AxxAxx/AxxLoad/HARDWARE/eagle design files/AxxLOAD_V2/Assembly/PnP_electronicload_front.txt

LD1	-94.05	16.55	0.00		CHIP-LED0805
LD2	-94.05	26.95	0.00		CHIP-LED0805
LD3	-92.00	-30.00	180.00		CHIP-LED0805
LD4	-108.00	-30.00	180.00		CHIP-LED0805
LD5	-94.30	33.00	270.00	HSMF-A201-A00J1	AVAGO_PLCC4
R13	-89.50	34.00	180.00	330	R0805
R17	-89.50	32.00	180.00	330	R0805
R23	-94.05	12.55	270.00	15	R0805
R24	-94.05	22.95	270.00	15	R0805
R25	-108.00	-26.00	270.00	15	R0805
