AxxAxx/AxxLoad/HARDWARE/BOM.xlsx

https://www.elfa.se/en/surge-stopper-34v-sot-23-linear-technology-ltc4365cts8-trmpbf/p/30167472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
https://www.elfa.se/en/mosfet-dual-channel-40v-powerpak-so-8l-vishay-sqj208ep-t1-ge3/p/30156768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
https://www.elfa.se/en/ntc-thermistor-ntc-10kohm-3984k-41mm-vishay-ntcle305e4103sb/p/30153875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
https://www.elfa.se/en/clip-for-heat-sink-to-264-ohmite-cla-t264-21e/p/30118216?track=true&no-cache=true
