AxxAxx/AxxLoad/(threads)

Thread 2 (2020-11-17):

Add Overvoltage protection for 12V Input

AxxAxx, 2020-11-17:
Protect the AxxLOAD by protecting the input circuit.
Example: https://circuitdigest.com/electronic-circuits/overvoltage-protection-circuit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,burn%20and%20break%20the%20circuit.
