AxxAxx/AxxLoad/Schematic.pdf

MICROCONTROLLER BOARD | OP-AMP CIRCUIT
+5V | +12V

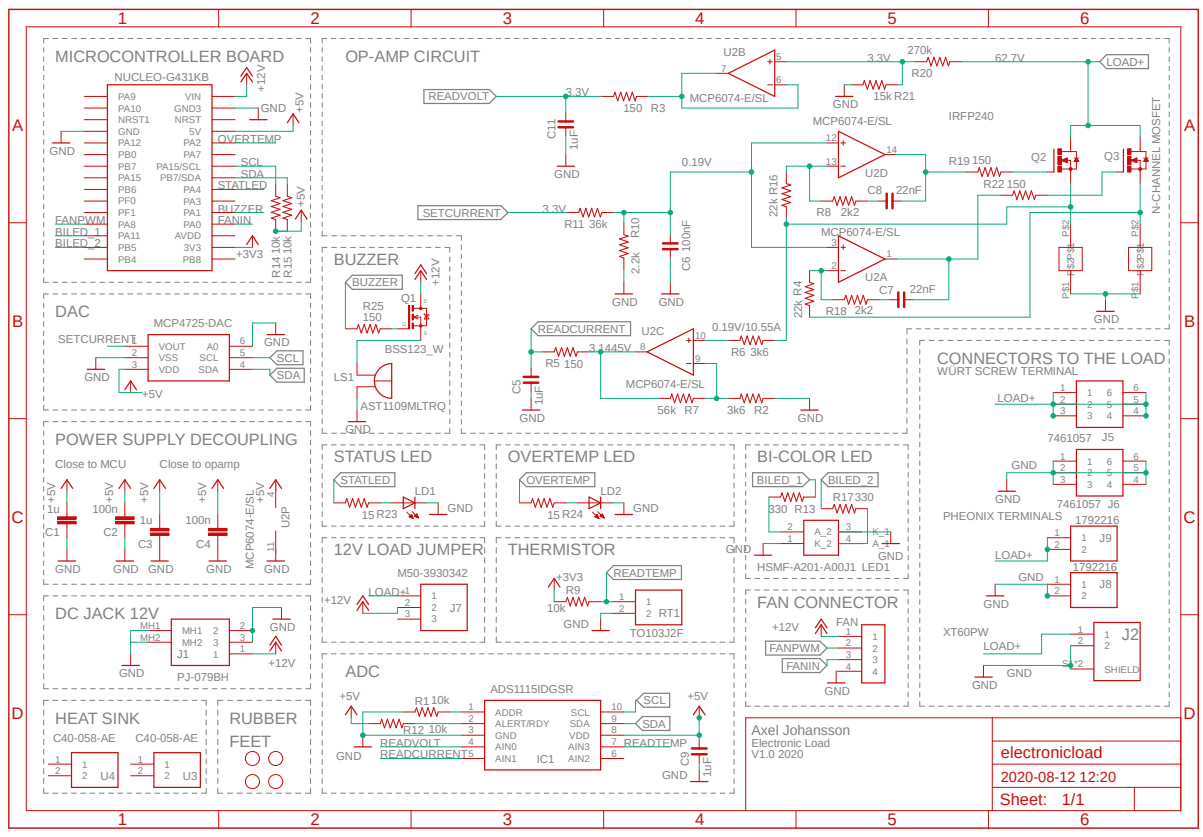
[picture p1: page 1]

CONNECTORS TO THE LOAD

3 | 3 4 | 4

C | GND 7461057 | C

Axel Johansson Electronic Load V1.0 2020

Sheet: 1/1
