AxxAxx/AxxLoad/HARDWARE/eagle design files/electronicload.brd

## EAGLE design HARDWARE/eagle design files/electronicload.brd (2020-11-15)

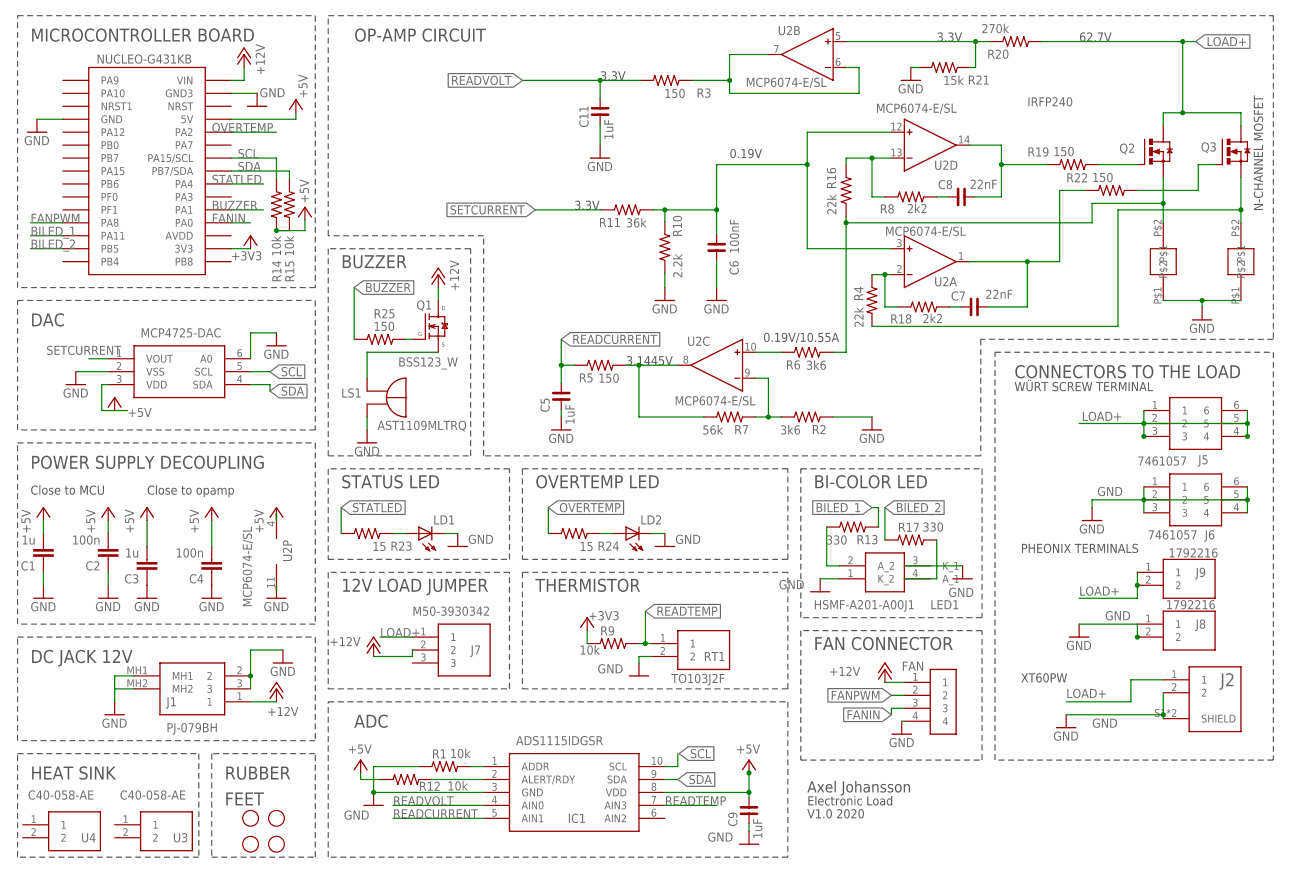
[picture p2: schematic electronicload.sch]

Parts:
C1, C3: 1u; C0603K; TOLERANCE 10%; VOLTAGE 16V; DIGIKEY 311-1444-1-ND
C2, C4: 100n; C0603K; TOLERANCE 10%; VOLTAGE 50V; DIGIKEY 445-7456-1-ND
C5, C9, C11: 1uF; C0805
C6: 100nF; C0805
C7, C8: 22nF; C0805
FAN: B4B-PH-K-S(LF)(SN); JST_B4B-PH-K-S(LF)(SN)
IC1: ADS1115IDGSR; SOP50P490X110-10N
J1: PJ-079BH; PJ079BH
J2: XT60PW-F; AMASS_XT60PW-F
J5, J6: 7461057
J7: M50-3930342; M503930342
J8, J9: 1792216
LD1, LD2: LEDCHIP-LED0805; CHIP-LED0805
LED1: HSMF-A201-A00J1; AVAGO_PLCC4
LS1: AST1109MLTRQ; XDCR_AST1109MLTRQ
MCP4725-DAC: MCP4725A0T-E_CH; SOT95P270X145-6N
Q1: BSS123_W; SOT23_GSD_W
Q2, Q3: IRFP240; TO247AC
R1, R9, R12, R14, R15: 10k; R0805
R2, R6: 3k6; R0805
R3, R5, R19, R22, R25: 150; R0805
R4, R16: 22k; R0805
R7: 56k; R0805
R8, R18: 2k2; R0805
R10: 2.2k; R0805
R11: 36k; R0805
R13, R17: 330; R0805
R20: 270k; R0805
R21: 15k; R0805
R23, R24: 15; R0805
RT1: TO103J2F; TO508P483X1016X2337-2P
U2: MCP6074-E/SL; SO14
U3, U4: C40-058-AE; C40058AE
U$1: NANO
U$2, U$5, U$6, U$7: RUBBER_FEET
U$3, U$4: CURRENTSENSE_RESISTOR_SMD2817

Connections:
+3V3: R9.1, U$1.RX1 (3V3)
+5V: C1.2, C2.2, C3.2, C4.2, C9.2, IC1.8 (VDD), MCP4725-DAC.3 (VDD), R12.1, R14.1, R15.1, U2.4 (V+), U$1.D9 (5V)
+12V: FAN.1, J1.1, J7.2, Q1.D, U$1.D12 (VIN)
BILED_1: R13.1, U$1.RST (PA11)
BILED_2: R17.1, U$1.GND (PB5)
BUZZER: R25.1, U$1.D2 (PA1)
FANIN: FAN.3, U$1.GND1 (PA0)
FANPWM: FAN.2, U$1.5V (PA8)
GND: C1.1, C2.1, C3.1, C4.1, C5.1, C6.1, C9.1, C11.1, FAN.4, IC1.3 (GND), J1.2, J1.3, J1.MH1, J1.MH2, J2.2, J2.S1 (SHIELD), J2.S2 (SHIELD), J6.1, J6.2, J6.3, J6.4, J6.5, J6.6, J8.1, J8.2, LD1.C, LD2.C, LED1.1 (K_2), LED1.3 (K_1), LS1.2, MCP4725-DAC.2 (VSS), MCP4725-DAC.6 (A0), R1.1, R2.1, R10.2, R21.2, RT1.2, U2.11 (V-), U$1.A0 (GND), U$1.D11 (GND3), U$3.P$1, U$4.P$1
LOAD+: J2.1, J5.1, J5.2, J5.3, J5.4, J5.5, J5.6, J7.1, J9.1, J9.2, Q2.2 (D), Q3.2 (D), R20.1
unnamed: C8.1, R19.1, U2.14 (OUT)
unnamed: R3.1, U2.6 (IN-), U2.7 (OUT)
unnamed: R6.2, U2.10 (IN+)
unnamed: R8.1, R16.1, U2.13 (IN-)
unnamed: R20.2, R21.1, U2.5 (IN+)
unnamed: Q2.1 (G), R19.2
unnamed: R2.2, R7.1, U2.9 (IN-)
unnamed: IC1.1 (ADDR), R1.2
unnamed: R5.1, R7.2, U2.8 (OUT)
unnamed: IC1.2 (ALERT/RDY), R12.2
unnamed: LED1.4 (A_1), R17.2
unnamed: C8.2, R8.2
unnamed: LED1.2 (A_2), R13.2
unnamed: Q2.3 (S), R6.1, R16.2, U$4.P$2
unnamed: Q3.3 (S), R4.2, U$3.P$2
unnamed: R4.1, R18.1, U2.2 (IN-)
unnamed: C6.2, R10.1, R11.1, U2.3 (IN+), U2.12 (IN+)
unnamed: C7.2, R18.2
unnamed: Q3.1 (G), R22.2
unnamed: C7.1, R22.1, U2.1 (OUT)
unnamed: LD1.A, R23.1
unnamed: LD2.A, R24.1
unnamed: LS1.1, Q1.S
unnamed: Q1.G, R25.2
OVERTEMP: R24.2, U$1.D8 (PA2)
READCURRENT: C5.2, IC1.5 (AIN1), R5.2
READTEMP: IC1.7 (AIN3), R9.2, RT1.1
READVOLT: C11.2, IC1.4 (AIN0), R3.2
SCL: IC1.10 (SCL), MCP4725-DAC.5 (SCL), R14.2, U$1.D6 (PA15/SCL)
SDA: IC1.9 (SDA), MCP4725-DAC.4 (SDA), R15.2, U$1.D5 (PB7/SDA)
SETCURRENT: MCP4725-DAC.1 (VOUT), R11.2
STATLED: R23.2, U$1.D4 (PA4)

Notes on the sheet:
POWER SUPPLY DECOUPLING
PHEONIX TERMINALS
WÜRT SCREW TERMINAL
N-CHANNEL MOSFET
3.3V
62.7V
0.19V
0.19V/10.55A
3.1445V
Electronic Load
V1.0 2020
Close to MCU
Close to opamp
HEAT SINK
CONNECTORS TO THE LOAD
MICROCONTROLLER BOARD
OP-AMP CIRCUIT
Axel Johansson
DAC
RUBBER
FEET
DC JACK 12V
THERMISTOR
ADC
FAN CONNECTOR
XT60PW
BI-COLOR LED
12V LOAD JUMPER
STATUS LED
OVERTEMP LED
BUZZER

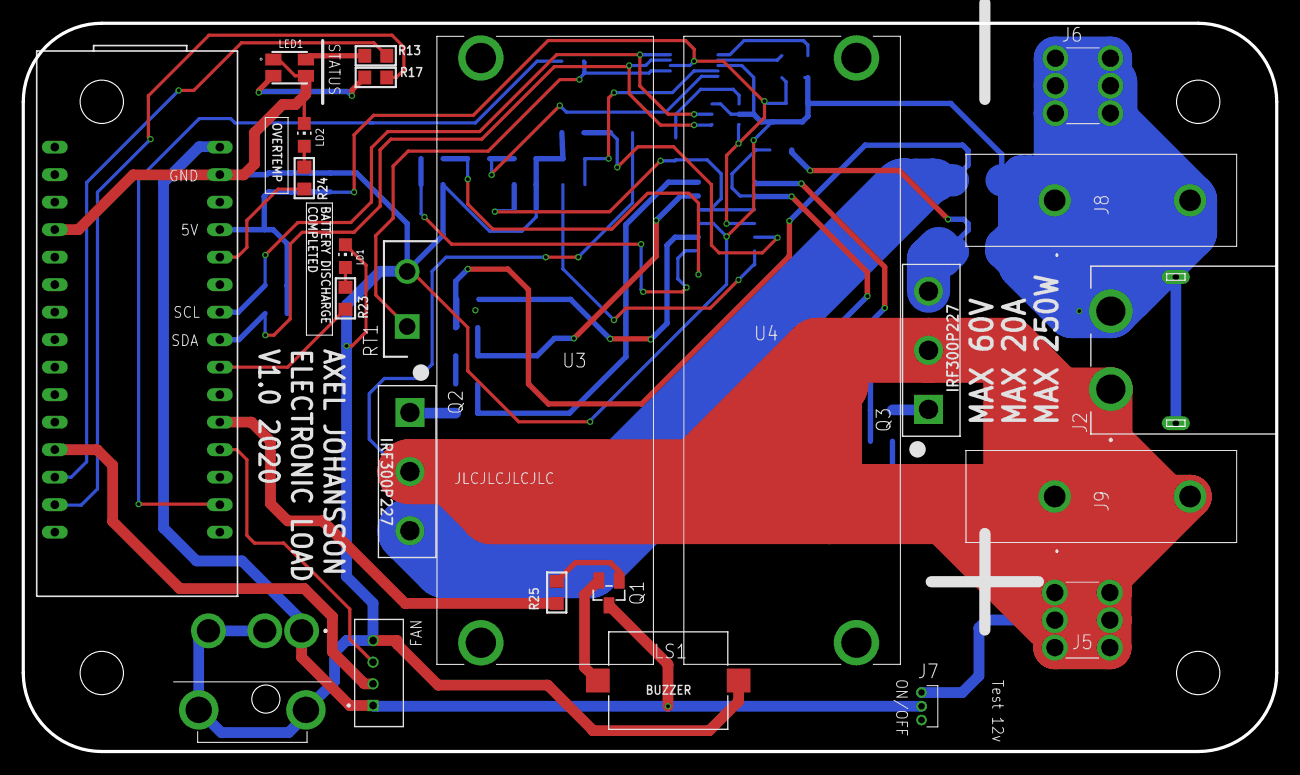
[picture p3: board electronicload.brd from above]

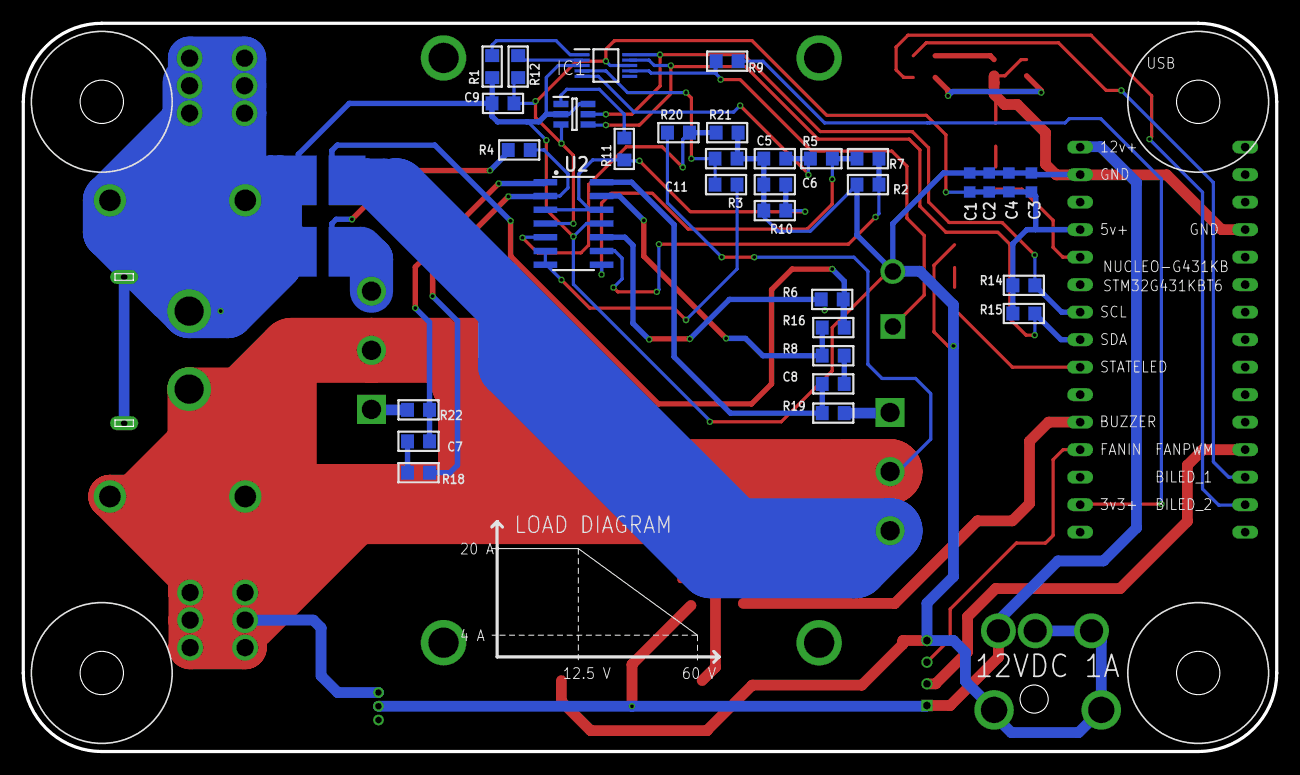
[picture p4: board electronicload.brd from below]

Board: 2 copper layers, 115.8 x 67.2 mm, 63 parts (35 on the bottom side), 42 nets.
