AxxAxx/AxxLoad/SOFTWARE/STM32G431_AxxLOAD/Core/Src/main.c

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
/* Includes ------------------------------------------------------------------*/
#include "main.h"

/* USER CODE BEGIN Includes */
#include "string.h"
#include <stdbool.h>

/* USER CODE END Includes */

/* USER CODE BEGIN PD */
volatile int line_valid = 0;
#define LINEMAX 16 // Maximal allowed/expected line length
static char line_buffer[LINEMAX]; // Holding buffer with space for terminating NUL
static char rx_buffer[LINEMAX]; // Local holding buffer to build line
void substring(char [], char[], int, int);
/* USER CODE END PD */

ADC_HandleTypeDef hadc1;
ADC_HandleTypeDef hadc2;

I2C_HandleTypeDef hi2c1;

TIM_HandleTypeDef htim1;
TIM_HandleTypeDef htim2;
TIM_HandleTypeDef htim3;
TIM_HandleTypeDef htim4;

UART_HandleTypeDef huart1;
UART_HandleTypeDef huart2;
DMA_HandleTypeDef hdma_usart2_rx;

/* USER CODE BEGIN PV */
#define ADS1115_ADDRESS 0x48
int16_t reading;

char byte, rx;
char chardata[15];
uint8_t dimmer=0;
uint16_t command_value = 0;
bool reportStatus = false;
bool CW_MODE = false;
bool CR_MODE = false;
bool PULSE_MODE = false;

bool PULSE_TOGGLE = false;

txDone = true;
autoFanSpeedMode = true;
uint32_t previousMillis = 0;
uint32_t previousMillis_INTEGRATION = 0;
uint32_t previousMillis_PULSE = 0;

uint32_t zeroTimeValue = 0;
uint32_t statusInterval = 500;           // interval at which to blink (milliseconds)
uint32_t integrationTime = 0;
uint32_t milliAmpHours = 0;
uint32_t milliWattHours = 0;
uint16_t setCurrent = 0;           // interval at which to blink (milliseconds)
float voltageCompensationConstant = 3.57081997924;
float currentCompensationConstant = 1.01125769786;
float temperatureCompensationConstant = 1; //VOLT: 1.98 (16 deg) - 0.065 (152 deg)
unsigned char ADSwrite[6];

uint16_t maxTemp = 120;
uint16_t maxAmpDiff = 0;
uint16_t maxWatt = 250;
uint16_t maxCurrent = 20;

uint16_t minVolt = 0;

uint16_t pulseLength = 0;
uint16_t pulseCurrent = 0;

int16_t ADS11115_VOLT = 0;
int16_t ADS11115_CURRENT = 0;
int16_t ADS11115_TEMPERATURE = 0;

struct statusValues {
	uint32_t   timestamp;
	uint16_t   HEATSINK_Temp;
	uint16_t   setCurrent;
	uint16_t   setPower;
	uint16_t   setResistance;
	uint16_t   measuredCurrent;
	uint16_t   measuredVoltage;
	uint16_t   measuredEquivalentResistance;
	uint16_t   MOSFET1_Temp;
	uint16_t   MOSFET2_Temp;
	uint16_t   PCB_Temp;
	uint32_t   measuredPower;
	float   amperehours;
	float   watthours;
	uint16_t fanSpeed;
};


/* USER CODE END PV */

void SystemClock_Config(void);
static void MX_GPIO_Init(void);
static void MX_DMA_Init(void);
static void MX_I2C1_Init(void);
static void MX_TIM1_Init(void);
static void MX_USART2_UART_Init(void);
static void MX_TIM4_Init(void);
static void MX_TIM2_Init(void);
static void MX_ADC1_Init(void);
static void MX_ADC2_Init(void);
static void MX_TIM3_Init(void);
static void MX_USART1_UART_Init(void);
/* USER CODE BEGIN PFP */
USART2_IRQHandler();
/* USER CODE END PFP */

/* USER CODE BEGIN 0 */

void HAL_UART_TxCpltCallback(UART_HandleTypeDef *UartHandle){
	/* Set transmission flag: transfer complete */
	txDone = true;
}

// This callback is called by the HAL_UART_IRQHandler when the given number of bytes are received
void HAL_UART_RxCpltCallback(UART_HandleTypeDef *huart){
	HAL_UART_Receive_IT(&huart2, &byte, 1);//Restart the interrupt reception mode
	static int rx_index = 0;
	//if (USART_GetITStatus(USART2, USART_IT_RXNE) != RESET) // Received character?
	if (huart->Instance == USART2)
	{
		//char rx = HAL_UART_Receive_IT(&huart2, &byte, 1);
		//HAL_UART_Transmit(&huart2, &byte, 1, 10);
		rx = byte;
		if ((rx == '\r') || (rx == '\n')) // Is this an end-of-line condition, either will suffice?
		{
			if (rx_index != 0) // Line has some content?
			{
				memcpy((void *)line_buffer, rx_buffer, rx_index); // Copy to static line buffer from dynamic receive buffer
				line_buffer[rx_index] = 0; // Add terminating NUL
				line_valid = 1; // flag new line valid for processing
				rx_index = 0; // Reset content pointer
				memset(&rx_buffer, '\0', sizeof(rx_buffer));
			}
		}
		else
		{
			if (rx_index == LINEMAX) // If overflows pull back to start
				rx_index = 0;
			rx_buffer[rx_index++] = rx; // Copy to buffer and increment
		}
	}
}

/* USER CODE END 0 */

/**
  * @brief  The application entry point.
  * @retval int
  */
int main(void)
{
  /* USER CODE BEGIN 1 */
	//Connect ADDR pin to GND and I2C slave adress will be 0X48 .
	unsigned char ADSwrite[6];
	int16_t voltage[3];
	struct statusValues my_statusValues;        /* Declare Book1 of type Book */
	my_statusValues.amperehours=0;
	my_statusValues.watthours=0;
	my_statusValues.setCurrent=0;
  /* USER CODE END 1 */

  /* MCU Configuration--------------------------------------------------------*/

  /* Reset of all peripherals, Initializes the Flash interface and the Systick. */
  HAL_Init();

  /* Configure the system clock */
  SystemClock_Config();

  /* Initialize all configured peripherals */
  MX_GPIO_Init();
  MX_DMA_Init();
  MX_I2C1_Init();
  MX_TIM1_Init();
  MX_USART2_UART_Init();
  MX_TIM4_Init();
  MX_TIM2_Init();
  MX_ADC1_Init();
  MX_ADC2_Init();
  MX_TIM3_Init();
  MX_USART1_UART_Init();
  /* USER CODE BEGIN 2 */
  HAL_TIM_Base_Start(&htim1);
  HAL_TIM_PWM_Start(&htim1,TIM_CHANNEL_1); //Start Pwm signal on PB-6 Pin

  HAL_TIM_Base_Start(&htim3);
  HAL_TIM_PWM_Start(&htim3,TIM_CHANNEL_3); //Start Pwm signal on PB-6 Pin

  HAL_UART_Receive_IT(&huart2, &byte, 1);//Start the interrupt reception mode
  /* USER CODE END 2 */

  /* Infinite loop */
  /* USER CODE BEGIN WHILE */

  while (1)
  {
    /* USER CODE END WHILE */

    /* USER CODE BEGIN 3 */
	    for(int i=0; i< 3; i++){
	    	ADSwrite[0] = 0x01;
	    				switch(i){
	    					case(0):
	    						ADSwrite[1] = 0xC1; //11000001
	    					break;
	    					case(1):
	    						ADSwrite[1] = 0xD1; //11010001
	    					break;
	    					case(2):
								ADSwrite[1] = 0xF1;//ADSwrite[1] = 0xE1;
	    					break;
	    				}

	    				ADSwrite[2] = 0x83; //10000011 LSB

	    				HAL_I2C_Master_Transmit(&hi2c1, ADS1115_ADDRESS << 1, ADSwrite, 3, 100);
	    				ADSwrite[0] = 0x00;
	    				HAL_I2C_Master_Transmit(&hi2c1, ADS1115_ADDRESS << 1 , ADSwrite, 1 ,100);
	    				HAL_Delay(10);//20

	    				HAL_I2C_Master_Receive(&hi2c1, ADS1115_ADDRESS <<1, ADSwrite, 2, 100);
	    				reading = (ADSwrite[0] << 8 | ADSwrite[1] );
	    				if(reading < 0) {
	    					reading = 0;
	    				}

	    				voltage[i] = reading;
	    		}

	    // Get ADC value
	HAL_ADC_Start(&hadc1);
	HAL_ADC_PollForConversion(&hadc1, HAL_MAX_DELAY);
	my_statusValues.MOSFET1_Temp = adc2Temperature(HAL_ADC_GetValue(&hadc1),3500);

	HAL_ADC_Start(&hadc2);
	HAL_ADC_PollForConversion(&hadc2, HAL_MAX_DELAY);
	my_statusValues.MOSFET2_Temp = adc2Temperature(HAL_ADC_GetValue(&hadc2),3500);

	HAL_ADC_PollForConversion(&hadc2, HAL_MAX_DELAY);
	my_statusValues.PCB_Temp = adc2Temperature(HAL_ADC_GetValue(&hadc2),3500);

	my_statusValues.measuredVoltage = voltage[0] * voltageCompensationConstant;
	my_statusValues.measuredCurrent = voltage[1] * currentCompensationConstant;
	my_statusValues.measuredEquivalentResistance = 1000*my_statusValues.measuredVoltage/my_statusValues.measuredCurrent;
	my_statusValues.HEATSINK_Temp = adc2Temperature(voltage[2],16628);

	my_statusValues.measuredPower = (my_statusValues.measuredVoltage*my_statusValues.measuredCurrent)/1000;
	my_statusValues.timestamp = (HAL_GetTick()-zeroTimeValue);

	integrationTime = HAL_GetTick()-previousMillis_INTEGRATION;
	my_statusValues.amperehours = my_statusValues.amperehours + integrationTime * my_statusValues.measuredCurrent/3600000.0;
	my_statusValues.watthours = my_statusValues.watthours + (integrationTime * my_statusValues.measuredCurrent/3600000.0) * (my_statusValues.measuredVoltage /1000.0);
	previousMillis_INTEGRATION = HAL_GetTick();


	//Set current by setting voltage drop over shunt
	MCP4725_write(&hi2c1, my_statusValues.setCurrent);

	if (line_valid==1){ // A new line has arrived
		BEEP(&htim3);
		line_valid = 0; // clear pending flag
		debugPrint(&huart2, "Sent command: ");
		debugPrintln(&huart2, line_buffer);
		int i = 0;
		char *p = strtok (line_buffer, " ");
		char *array[4];

		while (p != NULL){
			array[i++] = p;
			p = strtok (NULL, " ");}

		if((strncmp(array[0], "??" ,10) == 0) ||  (strncmp(array[0], "help" ,10) == 0) || (strncmp(array[0], "h" ,10) == 0)){
			printHELP(&huart2,my_statusValues);}

		else if(strncmp(array[0], "fs" ,10) == 0){
			if ((strncmp(array[1], "A" ,10) == 0) || (strncmp(array[1], "a" ,10) == 0)){
				autoFanSpeedMode=true;
				debugPrintln(&huart2, "Setting fan speed to Auto");}
			else{
				my_statusValues.fanSpeed = stringToInt(array[1]);
				setFanSpeed(&huart2, &htim1, my_statusValues);
				autoFanSpeedMode=false;
			}
		}

		else if(strncmp(array[0], "mv" ,10) == 0){
			command_value = stringToInt(array[1]);
			minVolt = command_value;
			debugPrint(&huart2, "Setting min voltage to: ");
			debugPrint(&huart2, array[1]);
			debugPrintln(&huart2, "mV");
			}

		else if(strncmp(array[0], "pm" ,10) == 0){
			command_value = stringToInt(array[1]);
			pulseLength = command_value;
			command_value = stringToInt(array[2]);
			pulseCurrent = command_value;

			debugPrint(&huart2, "Setting Pulse Length to: ");
			debugPrint(&huart2, array[1]);
			debugPrintln(&huart2, " ms");


			debugPrint(&huart2, "Setting Pulse Current to: ");
			debugPrint(&huart2, array[2]);
			debugPrintln(&huart2, " mA");

			PULSE_MODE = true;
			reportStatus = true;
			}

		else if(strncmp(array[0], "cc" ,10) == 0){
			if (stringToInt(array[1]) <= 20000){
				my_statusValues.setCurrent = stringToInt(array[1]);
				reportStatus = true;
				CW_MODE = false;
				CR_MODE = false;
				PULSE_MODE = false;
			}

			else{
				debugPrintln(&huart2, "Requested current is too high... Max current is 20 A");}
			}

		else if(strncmp(array[0], "cp" ,10) == 0){
			my_statusValues.setPower = stringToInt(array[1]);
			if (my_statusValues.setPower <= 250){
				reportStatus = true;
				CW_MODE = true;
				CR_MODE = false;
				PULSE_MODE = false;
			}
			else{
				debugPrintln(&huart2, "Requested power is too high... Max power is 250 W");}
			}

		else if(strncmp(array[0], "cr" ,10) == 0){
			if (stringToInt(array[1]) > 0){
				my_statusValues.setResistance = stringToInt(array[1]);
			}
			else {
				debugPrintln(&huart2, "Hey, can't divide with Zero!");
			}

			reportStatus = true;
			CR_MODE = true;
			CW_MODE = false;
			PULSE_MODE = false;
		}

		else if(strncmp(array[0], "status" ,10) == 0){
			printStatus(my_statusValues, &huart2);
		}

		else if((strncmp(array[0], "stop" ,10) == 0) || strncmp(array[0], "s" ,10) == 0){
			reportStatus = false;
			my_statusValues.setCurrent = 0;
			CW_MODE = false;
			CR_MODE = false;
			PULSE_MODE = false;
			debugPrintln(&huart2, "Received STOP, STOPPING.....");
			printStatus(my_statusValues, &huart2);

		}

		else if(strncmp(array[0], "reset" ,10) == 0){
			debugPrintln(&huart2, "Resetting mAh, mWh and time");
			my_statusValues.amperehours=0;
			my_statusValues.watthours=0;
			zeroTimeValue = HAL_GetTick();
		}

		else if(strncmp(array[0], "log" ,10) == 0){
			statusInterval=stringToInt(array[1]);
		}

		else{
			debugPrintln(&huart2, "Unknown command..., showing HELP");
			printHELP(&huart2,my_statusValues);}
			memset(&line_buffer, '\0', sizeof(line_buffer));
		}

	  HAL_GPIO_TogglePin(GPIOB, LED_Pin); //Toggle LED
	  //HAL_GPIO_TogglePin(GPIOA,  DISCHARGE_LED_Pin); //Toggle LED
	  //HAL_GPIO_TogglePin(GPIOB,  OVERTEMP_Pin);


	  if(PULSE_MODE){
		  if(HAL_GetTick() - previousMillis_PULSE >= pulseLength){
			  if (PULSE_TOGGLE){
				  PULSE_TOGGLE = false;
				  my_statusValues.setCurrent = pulseCurrent;
				  HAL_GPIO_TogglePin(GPIOA, BILED_1_Pin); //Toggle LED
			  }
			  else{
				  PULSE_TOGGLE = true;
				  my_statusValues.setCurrent = 0;
				  HAL_GPIO_TogglePin(GPIOA, BILED_2_Pin); //Toggle LED
			  }
			  previousMillis_PULSE = HAL_GetTick();
		  }
	  }

	  if(CW_MODE){
		  my_statusValues.setCurrent = 1000000.0*my_statusValues.setPower/my_statusValues.measuredVoltage;
	  }

	  if(CR_MODE){
		  my_statusValues.setCurrent = 1000*my_statusValues.measuredVoltage/my_statusValues.setResistance;
	  }

	  if(reportStatus){
		  if(HAL_GetTick() - previousMillis >= statusInterval){
			  printStatus(my_statusValues, &huart2);
				previousMillis = HAL_GetTick();
		  }
	  }

	  if (autoFanSpeedMode){
		  my_statusValues.fanSpeed = 1.7*(my_statusValues.HEATSINK_Temp/10.0)-36;
			if (my_statusValues.fanSpeed <= 15){
				my_statusValues.fanSpeed = 0;
			}

			if (my_statusValues.fanSpeed >= 100){
				my_statusValues.fanSpeed = 100;
			}
			autoFanSpeed(my_statusValues, &htim1);
	  }

	  if(my_statusValues.measuredVoltage<minVolt){
			my_statusValues.setCurrent = 0;
			reportStatus = false;
			BEEP(&htim3);
		  	debugPrintln(&huart2, "Min voltage reached. Stopped discharge");
	  }

	  if(my_statusValues.measuredPower/1000>maxWatt){
			my_statusValues.setCurrent = 0;
			reportStatus = false;
			BEEP(&htim3);
			debugPrintln(&huart2, "OVERPOWER, Stopped discharge");
	  }

	  if(my_statusValues.measuredCurrent/1000>maxCurrent){
			my_statusValues.setCurrent = 0;
			reportStatus = false;
			BEEP(&htim3);
			debugPrintln(&huart2, "OVERCURRENT, Stopped discharge");
	  }

	  if((my_statusValues.MOSFET1_Temp>maxTemp*10) || (my_statusValues.MOSFET2_Temp>maxTemp*10)){
			my_statusValues.setCurrent = 0;
			reportStatus = false;
			BEEP(&htim3);
			HAL_Delay(50);
			debugPrintln(&huart2, "OVERTEMP, Stopped discharge");
	  }
  }
  /* USER CODE END 3 */
}

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
/* USER CODE BEGIN 4 */
//HAL_GPIO_WritePin(GPIOA, BILED_1_Pin,GPIO_PIN_SET);               //If pressed Led Switch On
//HAL_GPIO_WritePin(GPIOA, BILED_1_Pin,GPIO_PIN_RESET);          //Else Led Switch Off

//HAL_GPIO_WritePin(GPIOA, STATLED_Pin,GPIO_PIN_SET);               //If pressed Led Switch On
//HAL_GPIO_WritePin(GPIOA, STATLED_Pin,GPIO_PIN_RESET);          //Else Led Switch Off
/* USER CODE END 4 */
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
