AxxAxx/AxxLoad/SOFTWARE/STM32G431_AxxLOAD/STM32G431_AxxLOAD.ioc

Mcu.UserName=STM32G431KBTx
PA0.GPIO_Label=FANIN
PA0.Signal=GPIO_Input
PA1.GPIO_Label=FET1_TEMP
PA1.Signal=ADC1_IN2
PA10.Signal=USART1_RX
PA11.GPIO_Label=BILED_1
PA11.Signal=GPIO_Output
PA12.GPIO_Label=DISCHARGE_LED
PA12.Signal=GPIO_Output
PA15.Signal=I2C1_SCL
PA2.Signal=USART2_TX
PA3.Signal=USART2_RX
PA4.GPIO_Label=FET2_TEMP
PA4.Signal=ADC2_IN17
PA7.GPIO_Label=PCB_TEMP
PA7.Signal=ADC2_IN4
PA8.GPIO_Label=FAN_PWM
PA8.Signal=S_TIM1_CH1
PA9.Signal=USART1_TX
PB0.GPIO_Label=BUZZER
PB0.Signal=S_TIM3_CH3
PB4.GPIO_Label=OVERTEMP
PB4.Signal=GPIO_Output
PB5.GPIO_Label=BILED_2
PB5.Signal=GPIO_Output
PB7.Signal=I2C1_SDA
PB8-BOOT0.GPIO_Label=LED
PB8-BOOT0.Signal=GPIO_Output
PF0-OSC_IN.Signal=RCC_OSC_IN
PF1-OSC_OUT.Signal=RCC_OSC_OUT
