AxxAxx/AxxLoad/PC GUI/Axxcom.py

#!/usr/bin/python
#
# A simple line based GUI serial terminal.
#
# Copyright (c) 2017 Joshua Henderson <digitalpeer@digitalpeer.com>
#
# SPDX-License-Identifier: GPL-3.0

"""AxxCom"""
import sys
import glob
import re
import codecs
import serial
from pkg_resources import parse_version
from qt import *
#dfrom . import __version__
__version__ = '2.1'
from guisave import *
from Axxcom_rc import *
cmdhistory = []

# By default, a thread is used to process the serial port. If this is set to
# False, a timer will poll the serial port at a fixed interval, whcih can have
# obvious negative side effects of delayed recv.
USE_THREAD = True

if USE_THREAD:
    from serialthread import * # pylint: disable=wrong-import-position

def serial_ports():
    """Gather all serial ports found on system."""
    if sys.platform.startswith('win'):
        ports = ['COM%s' % (i + 1) for i in range(256)]
    elif sys.platform.startswith('linux') or sys.platform.startswith('cygwin'):
        ports = glob.glob('/dev/tty[A-Za-z]*')
    elif sys.platform.startswith('darwin'):
        ports = glob.glob('/dev/tty.*')
    else:
        raise EnvironmentError('Unsupported platform')

    result = []
    for port in ports:
        try:
            ser = serial.Serial(port)
            ser.close()
            result.append(port)
        except (OSError, serial.SerialException):
            pass
    return result

def _chunks(text, chunk_size):
    """Chunk text into chunk_size."""
    for i in range(0, len(text), chunk_size):
        yield text[i:i+chunk_size]

def str_to_hex(text):
    """Convert text to hex encoded bytes."""
    return ''.join('{:02x}'.format(ord(c)) for c in text)

def hex_to_raw(hexstr):
    """Convert a hex encoded string to raw bytes."""
    return ''.join(chr(int(x, 16)) for x in _chunks(hexstr, 2))

def load_ui_widget(filename, this):
    """Abstracts out using custom loadUi(), necessry with pySide, or PYQt's uic.loadUi()."""
    if USE_QT_PY == PYSIDE:
        loadUi(filename, this)
    else:
        uic.loadUi(filename, this)

class SettingsDialog(QT_QDialog):
    """Settings dialog."""
    def __init__(self, parent=None):
        super(SettingsDialog, self).__init__(parent)
        load_ui_widget(os.path.join(os.path.dirname(__file__), 'settings.ui'), self)

        try:
            self.port.addItems(serial_ports())
        except EnvironmentError:
            pass

        self.buttonBox.accepted.connect(self.on_accept)

        self.baudrate.setCurrentIndex(self.baudrate.findText("115200"))

        self.bytesize.addItem("5", serial.FIVEBITS)
        self.bytesize.addItem("6", serial.SIXBITS)
        self.bytesize.addItem("7", serial.SEVENBITS)
        self.bytesize.addItem("8", serial.EIGHTBITS)
        self.bytesize.setCurrentIndex(self.bytesize.findText("8"))

        self.parity.addItem("None", serial.PARITY_NONE)
        self.parity.addItem("Even", serial.PARITY_EVEN)
        self.parity.addItem("Odd", serial.PARITY_ODD)
        self.parity.addItem("Mark", serial.PARITY_MARK)
        self.parity.addItem("Space", serial.PARITY_SPACE)
        self.parity.setCurrentIndex(self.parity.findText("None"))

        self.stopbits.addItem("1", serial.STOPBITS_ONE)
        self.stopbits.addItem("1.5", serial.STOPBITS_ONE_POINT_FIVE)
        self.stopbits.addItem("2", serial.STOPBITS_TWO)
        self.stopbits.setCurrentIndex(self.stopbits.findText("1"))

        self.settings = QtCore.QSettings('Axxcom', 'Axxcom')
        self.settings.beginGroup("settingsDialog")
        load(self, self.settings)
        self.settings.endGroup()
        

    def getValues(self):
        """
        Return a dictionary of settings.
        This returns direct attributes of the serial object.
        """
        return {'port':self.port.currentText(),
                'baudrate':int(self.baudrate.currentText()),
                'bytesize':self.bytesize.itemData(self.bytesize.currentIndex()),
                'parity':self.parity.itemData(self.parity.currentIndex()),
                'stopbits':self.stopbits.itemData(self.stopbits.currentIndex()),
                'xonxoff':self.xonxoff.isChecked(),
                'rtscts':self.rtscts.isChecked(),
                'dsrdtr':self.dsrdtr.isChecked()}

    def on_accept(self):
        """Accept changes."""
        self.settings.beginGroup("settingsDialog")
        save(self, self.settings,
                     ["port", "baudrate", "bytesize", "parity", "stopbits",
                      "xonxoff", "rtscts", "dsrdtr"])
        self.settings.endGroup()

class MainWindow(QT_QMainWindow):
    """The main window."""
    def __init__(self, parent=None):
        super(MainWindow, self).__init__(parent)
        load_ui_widget(os.path.join(os.path.dirname(__file__), 'Axxcom.ui'), self)
        self.serial = None

        ports = []
        try:
            ports = serial_ports()
        except EnvironmentError:
            pass
        if not len(ports):
            self.statusBar().showMessage(
                'No serial ports found.  You can try manually entering one.')

        self.btn_open.clicked.connect(self.on_btn_open)
        self.btn_send.clicked.connect(self.on_btn_send)
        self.input.returnPressed.connect(self.on_btn_send)
        self.input.installEventFilter(self)
        self.cmdhistory_pos = -1
        self.cmdhistory = []
        self.input.textChanged.connect(self.on_input_changed)
        self.line_end.currentIndexChanged.connect(self.on_input_changed)
        self.btn_clear.clicked.connect(self.on_btn_clear)
        self.btn_open_log.clicked.connect(self.on_btn_open_log)
        self.actionQuit.triggered.connect(QT_QApplication.quit)
        self.actionAbout.triggered.connect(self.on_about)
        self.history.itemDoubleClicked.connect(self.on_history_double_click)


        self.input.setEnabled(False)
        self.btn_send.setEnabled(False)
        self.history.setEnabled(False)

        self.settings = QtCore.QSettings('Axxcom', 'Axxcom')
        self.settings.beginGroup("mainWindow")
        load(self, self.settings)
        self.settings.endGroup()

        self.ansi_escape = re.compile(r'(\x9B|\x1B\[)[0-?]*[ -\/]*[@-~]')
        if parse_version(serial.VERSION) >= parse_version("3.0"):
            self.serial = serial.Serial(timeout=0.1,
                                        write_timeout=5.0,
                                        inter_byte_timeout=1.0)
        else:
            self.serial = serial.Serial(timeout=0.1,
                                        writeTimeout=5.0,
                                        interCharTimeout=1.0)
        if not USE_THREAD:
            self.timer = QtCore.QTimer()
            self.timer.timeout.connect(self.read_data)
        else:
            self.thread = SerialThread(self.serial)
            self.thread.recv.connect(self.recv)
            self.thread.recv_error.connect(self.recv_error)
    
    def eventFilter(self, obj, event):
        if obj is self.input and event.type() == QtCore.QEvent.KeyPress:
            if event.key() == QtCore.Qt.Key_Up:
                self.call_arrow_up()
                
            if event.key() == QtCore.Qt.Key_Down:
                self.call_arrow_down()
        return super().eventFilter(obj, event)
    
    def call_arrow_up(self):
        if self.cmdhistory_pos < len(self.cmdhistory)-1:
            self.cmdhistory_pos += 1
            self.input.setText(self.cmdhistory[self.cmdhistory_pos])
        
    def call_arrow_down(self):
        if self.cmdhistory_pos > 0:
            self.cmdhistory_pos -= 1
            self.input.setText(self.cmdhistory[self.cmdhistory_pos])




    def ui_connected_enable(self, connected):
        """Toggle enabled on controls based on connect."""
        if connected:
            self.btn_open.setText("&Close Device")
            self.on_input_changed()
        else:
            self.btn_open.setText("&Open Device")
            self.btn_send.setEnabled(connected)
        self.input.setEnabled(connected)
        self.history.setEnabled(connected)

    def on_btn_open(self):
        

        """Open button clicked."""
        if self.serial.isOpen():
            if not USE_THREAD:
                self.timer.stop()
                self.serial.close()
            else:
                self.thread.close()
            self.ui_connected_enable(False)
            self.statusBar().showMessage("Closed " + self.serial.port)
            self.serial_str.setText("Not connected")
        else:
            dlg = SettingsDialog(self)
            if dlg.exec_():
                settings = dlg.getValues()
                for key in settings:
                    setattr(self.serial, key, settings[key])
            else:
                return

            try:
                self.serial.open()
            except serial.SerialException as exp:
                QtGui.QMessageBox.critical(self, 'Error Opening Serial Port',
                                           str(exp))
            except (IOError, OSError) as exp:
                QtGui.QMessageBox.critical(self, 'IO Error Opening Serial Port',
                                           str(exp))
            else:
                if parse_version(serial.VERSION) >= parse_version("3.0"):
                    self.serial.reset_input_buffer() # pylint: disable=no-member
                    self.serial.reset_output_buffer() # pylint: disable=no-member
                else:
                    self.serial.flushInput() # pylint: disable=no-member
                    self.serial.flushOutput() # pylint: disable=no-member
                self.serial_str.setText('Connected to ' + settings['port'] +
                                        ' ' +
                                        str(settings['baudrate']) + ',' +
                                        str(settings['parity']) + ',' +
                                        str(settings['bytesize']) + ',' +
                                        str(settings['stopbits']))
                self.ui_connected_enable(True)
                self.statusBar().showMessage("Opened " + self.serial.port)
                if not USE_THREAD:
                    self.timer.start(100)
                else:
                    self.thread.start()

    def do_log(self, text):
        """Write to log file."""
        text = text.decode("utf-8")
        if self.remove_escape.isChecked():
            text = self.ansi_escape.sub('', text)
        if self.output_hex.isChecked():
            text = str_to_hex(text)
            text = ' '.join(a+b for a, b in zip(text[::2], text[1::2]))
            text = text + ' '
        self.log.moveCursor(QtGui.QTextCursor.End)
        self.log.insertPlainText(text)
        self.log.moveCursor(QtGui.QTextCursor.End)
        if self.enable_log.isChecked() and len(self.log_file.text()):
            with open(self.log_file.text(), "a") as handle:
                handle.write(text)

    def encode_input(self):
        """
        Interpret the user input text as hex or append appropriate line ending.
        """
        endings = [u"\n", u"\r", u"\r\n", u"\n\r", u"", u""]
        text = self.input.text()

        if self.line_end.currentText() == "Hex":
            text = ''.join(text.split())
            if len(text) % 2:
                raise ValueError('Hex encoded values must be a multiple of 2')
            text = hex_to_raw(text)
        else:
            text = text + endings[self.line_end.currentIndex()]
        return text.encode()

    def on_input_changed(self):
        """Input line edit changed."""
        try:
            self.encode_input()
        except ValueError:
            self.input.setStyleSheet("color: rgb(255, 0, 0);")
            self.btn_send.setEnabled(False)
            return
        self.input.setStyleSheet("color: rgb(0, 0, 0);")
        if self.serial is not None and self.serial.isOpen():
            self.btn_send.setEnabled(True)

    def on_btn_send(self):
        """Send button clicked."""
        if not self.serial.isOpen():
            return
        try:
            raw = self.encode_input()
            self.cmdhistory.insert(0,raw.strip().decode('utf-8'))
            self.cmdhistory_pos = -1
            if not USE_THREAD:
                ret = self.serial.write(raw)
            else:
                ret = self.thread.write(raw)
            self.statusBar().showMessage("Wrote " + str(ret) + " bytes")
        except serial.SerialException as exp:
            QtGui.QMessageBox.critical(self, 'Serial write error', str(exp))
            return
        except ValueError as exp:
            QtGui.QMessageBox.critical(self, 'Input Error', str(exp))
            return

        if self.echo_input.isChecked():
            self.do_log(raw)

        item = QT_QListWidgetItem(self.input.text())
        self.history.addItem(item)
        self.history.scrollToItem(item)

        self.input.clear()

    def on_btn_open_log(self):
        """Open log file button clicked."""
        dialog = QT_QFileDialog(self)
        dialog.setWindowTitle('Open File')
        dialog.setNameFilter("All files (*.*)")
        dialog.setFileMode(QtGui.QFileDialog.AnyFile)
        if dialog.exec_() == QT_QDialog.Accepted:
            filename = dialog.selectedFiles()[0]
            self.log_file.setText(filename)

    def on_history_double_click(self, item):
        """Send log item double clicked."""
        self.input.setText(item.text())
        self.on_btn_send()
        self.input.clear()

    def on_btn_clear(self):
        """Clear button clicked."""
        self.log.clear()

    def read_data(self):
        """Read serial port."""
        if self.serial.isOpen:
            try:
                text = self.serial.read(2048)
            except serial.SerialException as exp:
                QtGui.QMessageBox.critical(self, 'Serial read error', str(exp))
            else:
                self.recv(text)

    def recv(self, text):
        """Receive data from the serial port signal."""
        if len(text):
            self.statusBar().showMessage("Read " + str(len(text)) + " bytes")
            self.do_log(text)
            try:
                if text.decode("utf-8").split(" ")[0] == ">>":
                    #print(text.decode("utf-8").split())
                    self.heatsink_temp_label.setText(text.decode("utf-8").split()[2])
                    self.mosfet1_temp_label.setText(text.decode("utf-8").split()[3])
                    self.mosfet2_temp_label.setText(text.decode("utf-8").split()[4])
                    self.pcb_temp_label.setText(text.decode("utf-8").split()[5])
                    
                    self.setcurrent_label.setText(text.decode("utf-8").split()[6])
                    self.measuredcurrent_label.setText(text.decode("utf-8").split()[7])
                    
                    self.measuredvoltage_label.setText(text.decode("utf-8").split()[8])
                    self.measuredpower_label.setText(text.decode("utf-8").split()[9])
                    self.measured_eq_resistance_label.setText(text.decode("utf-8").split()[10])
                    self.discharged_ah_label.setText(text.decode("utf-8").split()[11])
                    self.discharged_wh_label.setText(text.decode("utf-8").split()[12])
                    self.fanspeed_label.setText(text.decode("utf-8").split()[13])
                    
                    
                    
            except:
                print("An exception occurred on Serial parse")
                    
    def recv_error(self, error):
        """Receive error when reading serial port from signal."""
        QtGui.QMessageBox.critical(self, 'Serial read error', error)
        if not USE_THREAD:
            self.timer.stop()
            self.serial.close()
        else:
            self.thread.close()

    def on_about(self):
        """About menu clicked."""
        msg = QtGui.QMessageBox(self)
        msg.setIcon(QtGui.QMessageBox.Information)
        msg.setText("AxxCom " + __version__)
        msg.setInformativeText("Copyright (c) 2020 Axel Johansson")
        msg.setWindowTitle("AxxCom - Axel Johansson 2020")
        with codecs.open('LICENSE.txt', encoding='utf-8') as f:
            msg.setDetailedText(f.read())
        msg.setStandardButtons(QtGui.QMessageBox.Ok)
        msg.exec_()

    def closeEvent(self, unused_event):
        """Handle window close event."""
        _ = unused_event
        if not USE_THREAD:
            self.timer.stop()
            self.serial.close()
        else:
            self.thread.close()
        self.settings.beginGroup("mainWindow")
        save(self, self.settings,
                     ["ui", "remove_escape",
                      "echo_input", "log_file", "enable_log", "line_end",
                      "zsplitter", "output_hex"])
        self.settings.endGroup()


def main():
    """Create main app and window."""
    app = QT_QApplication(sys.argv)
    app.setApplicationName("AxxCom")
    win = MainWindow(None)
    win.setWindowTitle("AxxCom " + __version__)
    win.show()
    sys.exit(app.exec_())

if __name__ == '__main__':
    main()
