AxxAxx/AxxLoad/PC GUI/Axxcom_rc.py

# -*- coding: utf-8 -*-

# Resource object code
#
# Created by: The Resource Compiler for PyQt4 (Qt v4.8.7)
#
# WARNING! All changes made in this file will be lost!

from qt import *

qt_resource_data = b"\
\x00\x00\x04\x70\
\x89\
\x50\x4e\x47\x0d\x0a\x1a\x0a\x00\x00\x00\x0d\x49\x48\x44\x52\x00\
\x00\x00\x20\x00\x00\x00\x20\x08\x06\x00\x00\x00\x73\x7a\x7a\xf4\
\x00\x00\x00\x09\x70\x48\x59\x73\x00\x00\x0b\x13\x00\x00\x0b\x13\
\x01\x00\x9a\x9c\x18\x00\x00\x00\x04\x67\x41\x4d\x41\x00\x00\xb1\
\x8e\x7c\xfb\x51\x93\x00\x00\x00\x20\x63\x48\x52\x4d\x00\x00\x7a\
\x25\x00\x00\x80\x83\x00\x00\xf9\xff\x00\x00\x80\xe9\x00\x00\x75\
\x30\x00\x00\xea\x60\x00\x00\x3a\x98\x00\x00\x17\x6f\x92\x5f\xc5\
\x46\x00\x00\x03\xe6\x49\x44\x41\x54\x78\xda\x62\xfc\xff\xff\x3f\
\xc3\x40\x02\x80\x00\x62\x62\x18\x60\x00\x10\x40\x03\xee\x00\x80\
\x00\x1a\x70\x07\x00\x04\x10\xcb\x40\x59\xec\xe9\xe9\x09\x4e\x7c\
\x00\x01\xc4\x48\x8d\x44\x08\x33\x0c\x04\xb6\x6f\xdf\xce\x48\x8c\
\xda\xce\xce\xce\xc3\x4c\x4c\x4c\x0c\x00\x01\xc4\x42\x0d\x4b\xa7\
\x4e\x9d\xca\xf0\xef\xef\x5f\x86\xbf\x40\x0c\x13\x47\x76\x08\xb2\
\xda\xa6\xa6\x26\xb0\xc5\xff\xfe\xfd\x63\x60\x64\x64\x64\x00\x08\
\x20\x92\x43\x00\x66\x58\x7d\x4d\x0d\xd8\x00\x90\x61\x75\x8d\x8d\
\x60\xb9\x9e\x9e\x1e\xb0\x23\x40\xb8\xaa\xaa\x0a\xae\xa7\xbc\xbc\
\xfc\x30\x33\x33\x33\x03\x0c\x83\xf4\xc0\xd8\x00\x01\x44\xb4\x03\
\x60\x16\xd7\x02\x0d\x66\x04\x1a\xc0\x04\x72\x3d\x90\x86\x39\x02\
\x44\x57\xd7\xd6\x32\xb4\xb5\xb6\x82\x1d\xf0\xe7\xcf\x1f\x86\xbf\
\x40\xdc\xd2\xd6\x06\xd6\x5f\x51\x51\x71\x18\xdd\xf2\xda\xda\x5a\
\x5b\x80\x00\x22\xe8\x00\x98\xc5\xd5\x15\x15\x70\x8b\x60\x34\xdc\
\x21\x48\x62\x15\xd5\xd5\x60\x7d\xd5\x40\x87\x22\x3b\xa4\x7f\xe2\
\x44\xb8\x23\x40\x18\x18\x15\xb6\xa0\x68\x02\x08\x20\xb0\x03\x90\
\xe3\x08\x16\x7f\x30\xb1\xaa\xf2\x72\x06\x06\x90\x05\x68\x16\x61\
\xa5\x91\x42\xa6\xa4\xac\x0c\x6c\x56\x41\x5e\x1e\xc4\x21\x40\x3c\
\x7d\xc6\x0c\x06\xf4\xc4\x0a\x10\x40\x8c\x1e\x1e\x1e\xff\xa1\x89\
\x83\x01\xe4\x98\xfa\xfa\x7a\xb8\xa2\x4a\xa0\x21\xc8\xbe\xc4\xf0\
\x3d\x3e\xc7\x40\x1d\x5d\x50\x5c\x8c\x11\xaa\xc8\x09\x14\x20\x80\
\xc0\x0e\x00\x0a\x80\x42\x01\x6c\x39\xc8\x11\x30\xdc\xd2\xd2\xc2\
\x00\x8b\x77\x06\x1c\x16\xe0\x73\x04\xb2\x9e\xdc\xfc\x7c\x86\xf8\
\x98\x18\x86\x85\x4b\x96\xa0\x38\x00\x20\x80\x58\x90\x5c\x05\x76\
\x04\x08\xd4\x00\x53\x38\x28\x9b\x54\x56\x56\x82\x1d\xd2\x0c\x4d\
\x48\x0d\xc0\x44\x06\x0e\x0d\x50\x11\x8a\x14\x2a\x70\x0c\xb5\x14\
\x4c\x83\x7c\x07\x55\x0b\xb2\x1c\x04\x40\xd1\x80\x0e\x00\x02\x88\
\x05\x9a\xd0\xe0\x8e\x40\xe6\x03\xb3\x0f\xd8\x01\xa5\xa5\xa5\x60\
\x07\x35\x34\x37\x33\x34\x35\x34\x80\x0d\x06\x5b\x80\x6c\x21\xb2\
\x43\xa0\x72\x20\x47\xe6\x16\x14\x30\x24\x27\x24\x30\xcc\x5d\xb0\
\x00\x9c\x20\xd1\x01\x40\x00\x61\x0d\x01\x74\x87\x14\x03\xe3\x11\
\xe4\x80\x02\xa0\x61\x75\x40\x07\x80\x40\x1b\x30\x7a\x18\x91\x7c\
\x09\x77\x14\x88\x86\x3a\x04\x64\x79\x58\x48\x08\xc3\xe7\x2f\x5f\
\xc0\x72\x7f\xb1\x38\x00\x20\x80\xe0\x0e\xf8\xf5\xeb\x17\xc3\xc6\
\x8d\x1b\x51\x2c\xde\xb2\x79\x33\xc3\x3f\x60\x08\xf8\xf9\xf9\x31\
\xe4\x03\x83\x11\x14\x1a\xb9\xb9\xb9\x60\xc7\x54\x01\xa3\x09\x04\
\xba\x3b\x3a\x10\x09\x14\xea\x98\x82\xa2\x22\xb0\x9c\xbb\xab\x2b\
\xc3\xc7\x8f\x1f\xe1\x96\xfd\xc5\x12\x05\x00\x01\x04\xcf\x05\x20\
\xb0\x62\xf9\x72\x14\xc9\x88\xc8\x48\x30\xbd\x76\xcd\x1a\x86\x60\
\xa0\x4f\x40\x20\x3b\x3b\x1b\xec\x00\x90\x63\x40\xf4\xac\x59\xb3\
\xc0\xe2\x7d\xc0\x52\x10\x96\xea\xcd\xcd\xcc\x30\x2c\x3a\x79\xea\
\x14\xd6\xba\x02\x20\x80\xe0\x0e\x98\x35\xbd\x84\x21\x2d\xb3\x07\
\x2c\x38\x77\xce\x1c\x14\xcd\xc9\x29\x29\x0c\xcb\x81\x8e\x03\x95\
\xf7\xd1\xc0\x94\x0c\x02\x69\x69\x69\x70\x87\x80\xf0\xbc\x79\xf3\
\xc0\xe2\xea\x6a\x6a\x18\x96\xdf\xbc\x75\x0b\x67\x45\x05\x10\x40\
\x28\x21\x00\x72\x04\xd8\x70\xa8\x43\x26\x01\x4b\x2f\x18\xc8\x83\
\xa6\xe4\x05\x40\x8b\xfe\x02\x2d\x06\x39\x0a\x04\x12\x13\x13\xe1\
\x8e\x58\xb8\x70\x21\x83\xb8\xa8\x28\x8a\x05\x2f\x5f\xbf\xc6\x5b\
\x43\x02\x04\x10\x0b\x36\xcb\x11\x6c\x88\xa5\xed\xc0\x6c\xd8\x0e\
\xcd\x8a\x09\x49\x49\x60\x7a\x26\xb0\x54\xfb\x0f\x74\x48\x46\x56\
\x16\x43\x5c\x5c\x1c\x03\xac\x48\xff\x00\x8d\xf3\x9f\xc0\x34\x45\
\x4c\xf5\x0c\x10\x40\x2c\x30\x05\xb0\xa2\x17\xbb\x43\x20\x35\x5b\
\x1d\x34\xe1\x81\xc0\x3f\xa4\x04\x05\x8b\x0a\x10\x00\x25\x3a\x0e\
\x4e\x4e\x82\x16\xc3\x00\x40\x00\xb1\xa0\x17\x8f\xb8\x1c\x02\xa2\
\x9b\x80\x59\xcf\xdc\xdc\x9c\xe1\xe4\xc9\x93\x28\x86\xc0\x12\x24\
\x08\x90\x62\x39\x08\x00\x04\x10\x0b\xae\x72\x1a\xdd\x21\x20\xa0\
\x06\x4c\x60\xef\xdf\xbf\xc7\x30\x04\x39\x04\x48\xb1\x1c\x04\x00\
\x02\x08\x67\x8b\x08\xdd\x21\x20\xf0\xfc\xf9\x73\x86\xcf\x9f\x3f\
\x63\xa8\x85\x25\x42\x72\x00\x40\x00\x11\x6c\x15\x23\xfb\x08\x64\
\x39\x8c\x9f\x09\x2c\x0f\x90\x43\x60\xe5\xca\x95\x24\xfb\x1e\x04\
\x00\x02\x88\xa2\x46\x29\x29\x8d\x51\x5c\x00\x20\x80\x18\x07\xba\
\x6b\x06\x10\x40\x03\xde\x31\x01\x08\xa0\x01\x77\x00\x40\x00\x0d\
\xb8\x03\x00\x02\x68\xc0\x1d\x00\x10\x60\x00\xb5\xca\xe4\xec\x04\
\xa3\x85\xa8\x00\x00\x00\x00\x49\x45\x4e\x44\xae\x42\x60\x82\
"

qt_resource_name = b"\
\x00\x05\
\x00\x6f\xa6\x53\
\x00\x69\
\x00\x63\x00\x6f\x00\x6e\x00\x73\
\x00\x05\
\x00\x36\x9b\x62\
\x00\x33\
\x00\x32\x00\x78\x00\x33\x00\x32\
\x00\x0b\
\x0a\xaa\x5c\xa7\
\x00\x74\
\x00\x69\x00\x6e\x00\x79\x00\x63\x00\x6f\x00\x6d\x00\x2e\x00\x70\x00\x6e\x00\x67\
"

qt_resource_struct = b"\
\x00\x00\x00\x00\x00\x02\x00\x00\x00\x01\x00\x00\x00\x01\
\x00\x00\x00\x00\x00\x02\x00\x00\x00\x01\x00\x00\x00\x02\
\x00\x00\x00\x10\x00\x02\x00\x00\x00\x01\x00\x00\x00\x03\
\x00\x00\x00\x20\x00\x00\x00\x00\x00\x01\x00\x00\x00\x00\
"

def qInitResources():
    QtCore.qRegisterResourceData(0x01, qt_resource_struct, qt_resource_name, qt_resource_data)

def qCleanupResources():
    QtCore.qUnregisterResourceData(0x01, qt_resource_struct, qt_resource_name, qt_resource_data)

qInitResources()
