AxxAxx/AxxLoad/(commit log)

2021-02-03 Added interpolation to fan speed controller
2021-02-04 added fan speed as serial output
    [BOM.xlsx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]
2021-06-11 fixed bug in temperature reading
    [main.c]
2023-09-02 change name of of electronicload.pdf to schematic.pdf
